io7m/wederian/Datasheets/Amphenol/USB Type-C Receptacle 12401610E4/USB Type-C Receptacle 12401610E4 - Amphenol.jpg

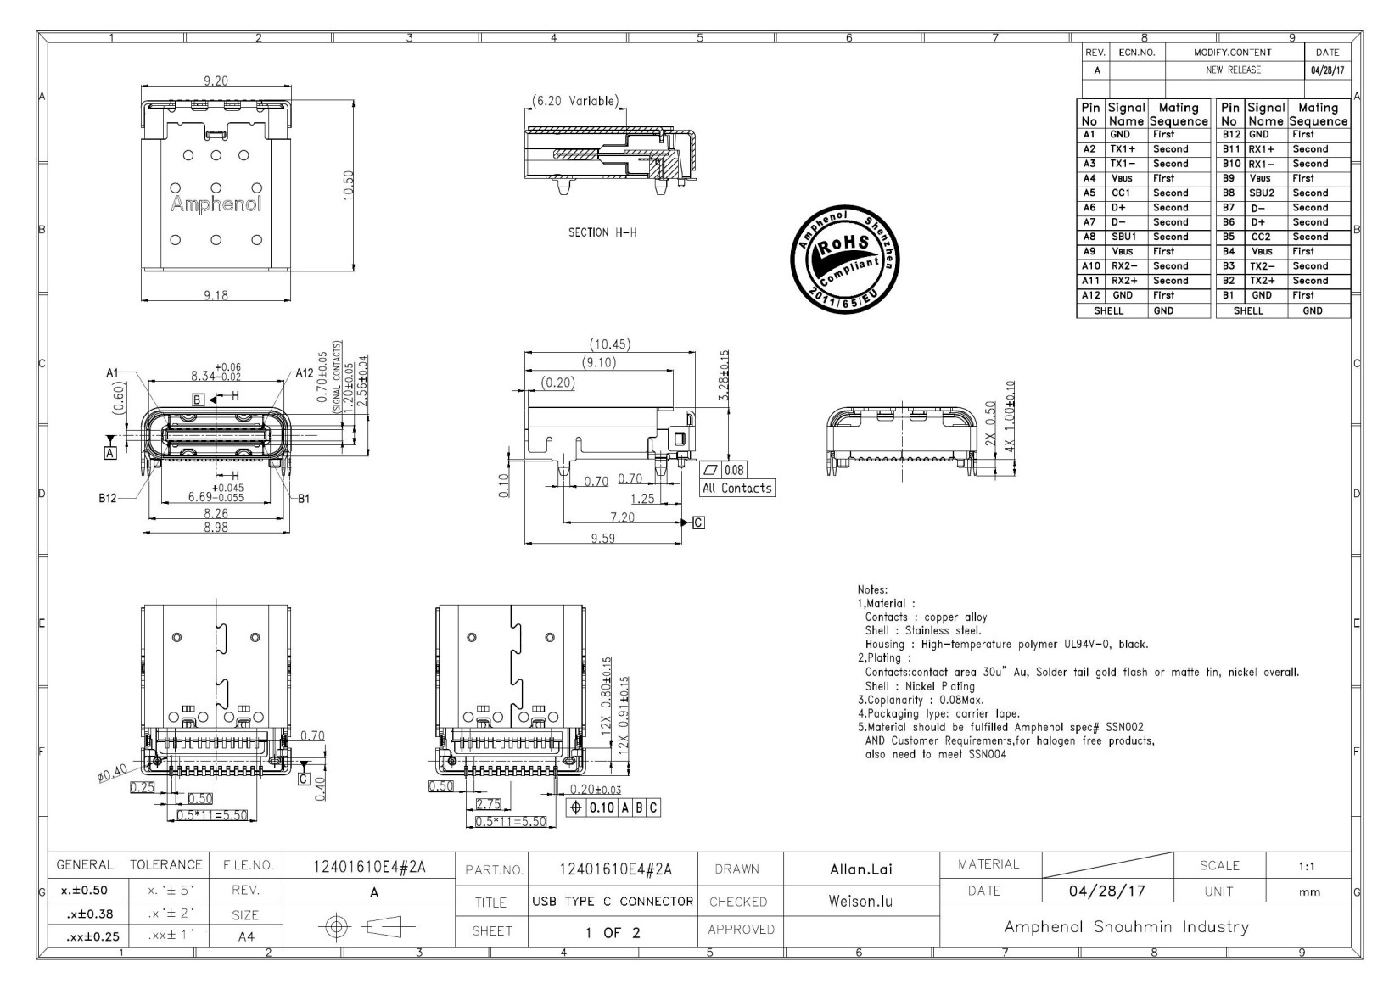
Datasheets/Amphenol/USB Type-C Receptacle 12401610E4/USB Type-C Receptacle 12401610E4 - Amphenol.jpg
