io7m/wederian/Datasheets/Atmel Corporation/ATmega16U4_32U4 Datasheet/ATmega16U4_32U4 Datasheet - Atmel Corporation.jpg

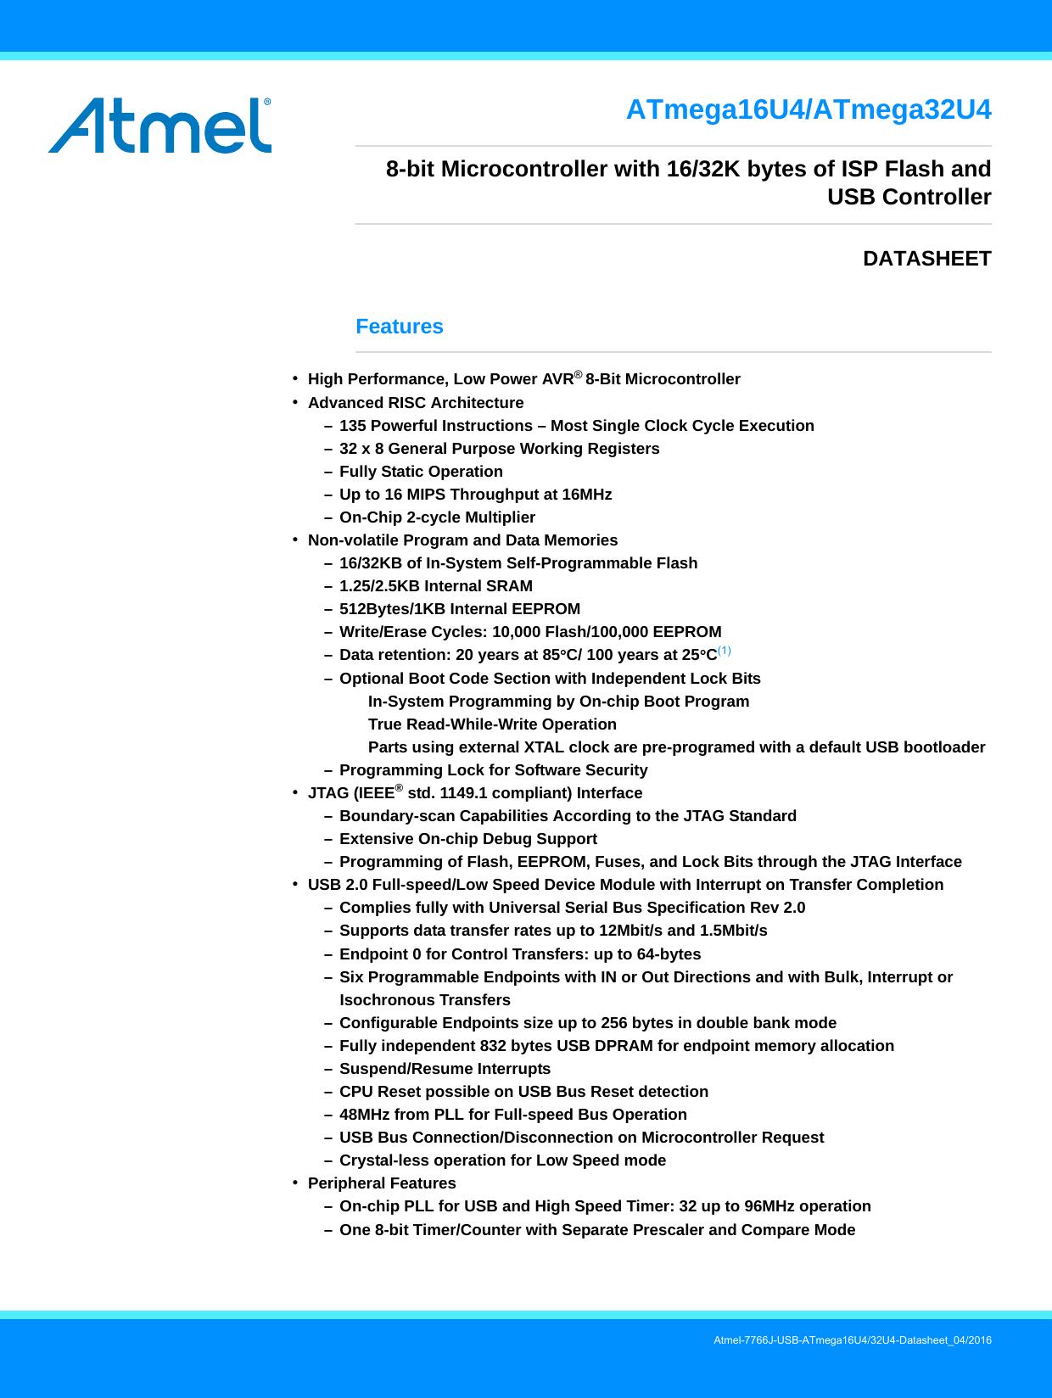
Datasheets/Atmel Corporation/ATmega16U4_32U4 Datasheet/ATmega16U4_32U4 Datasheet - Atmel Corporation.jpg
