io7m/wederian/Datasheets/Bourns, Inc_/ChipGuard® MLC Series ESD Protectors/ChipGuard® MLC Series ESD Protectors - Bourns, Inc_.jpg

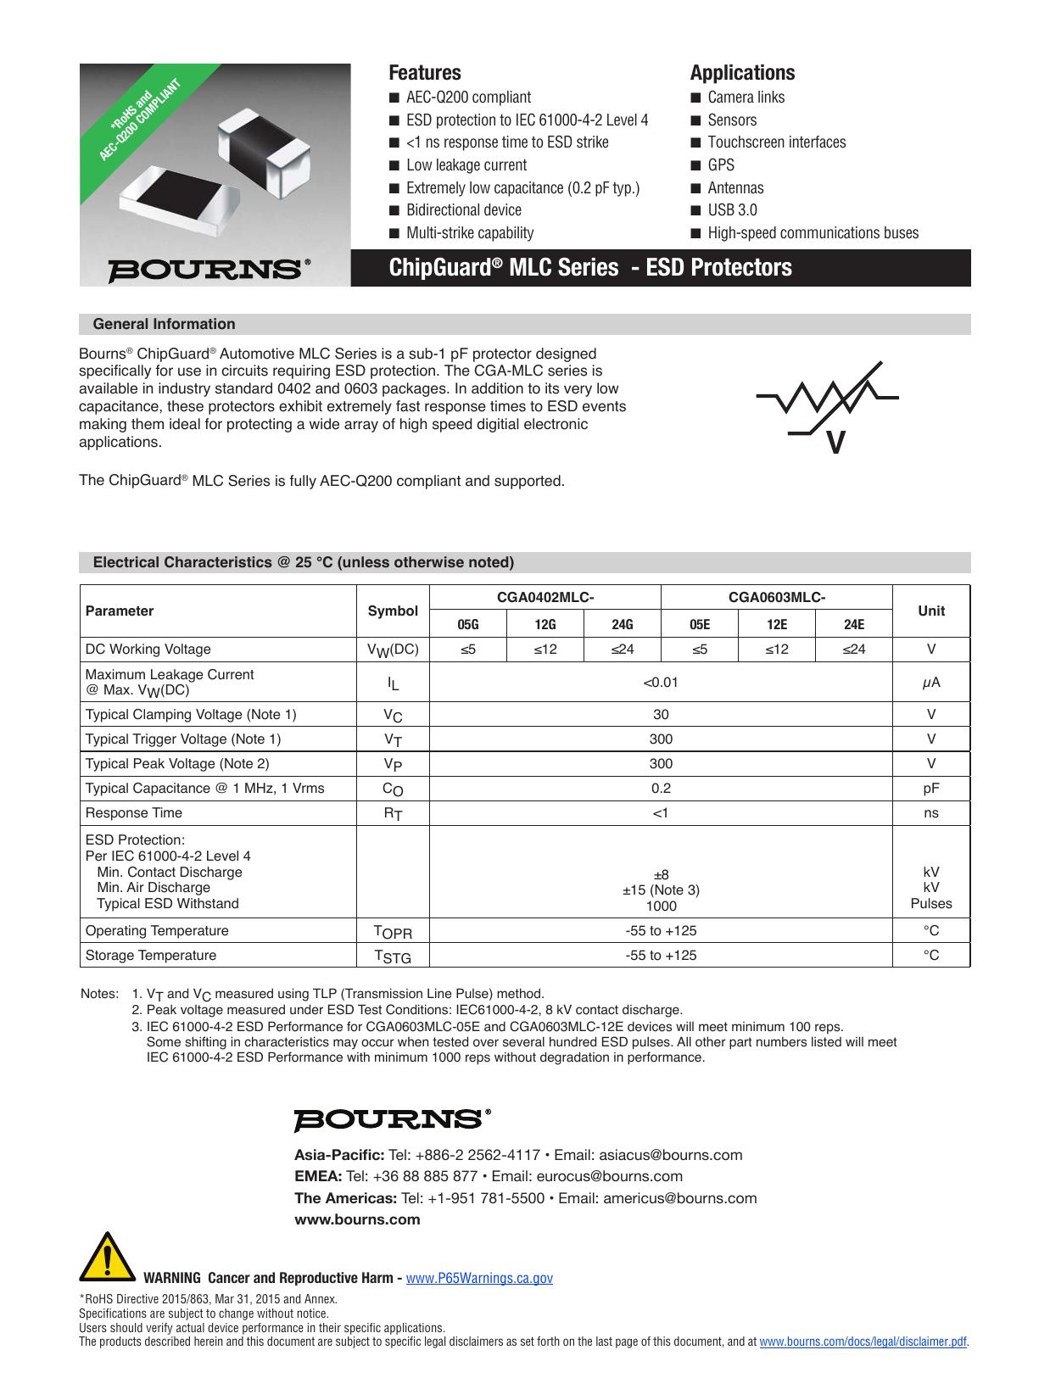
Datasheets/Bourns, Inc_/ChipGuard® MLC Series ESD Protectors/ChipGuard® MLC Series ESD Protectors - Bourns, Inc_.jpg
