io7m/wederian/Datasheets/Bourns, Inc_/MF-MSMF Series PTC Resettable Fuses/MF-MSMF Series PTC Resettable Fuses - Bourns, Inc_.jpg

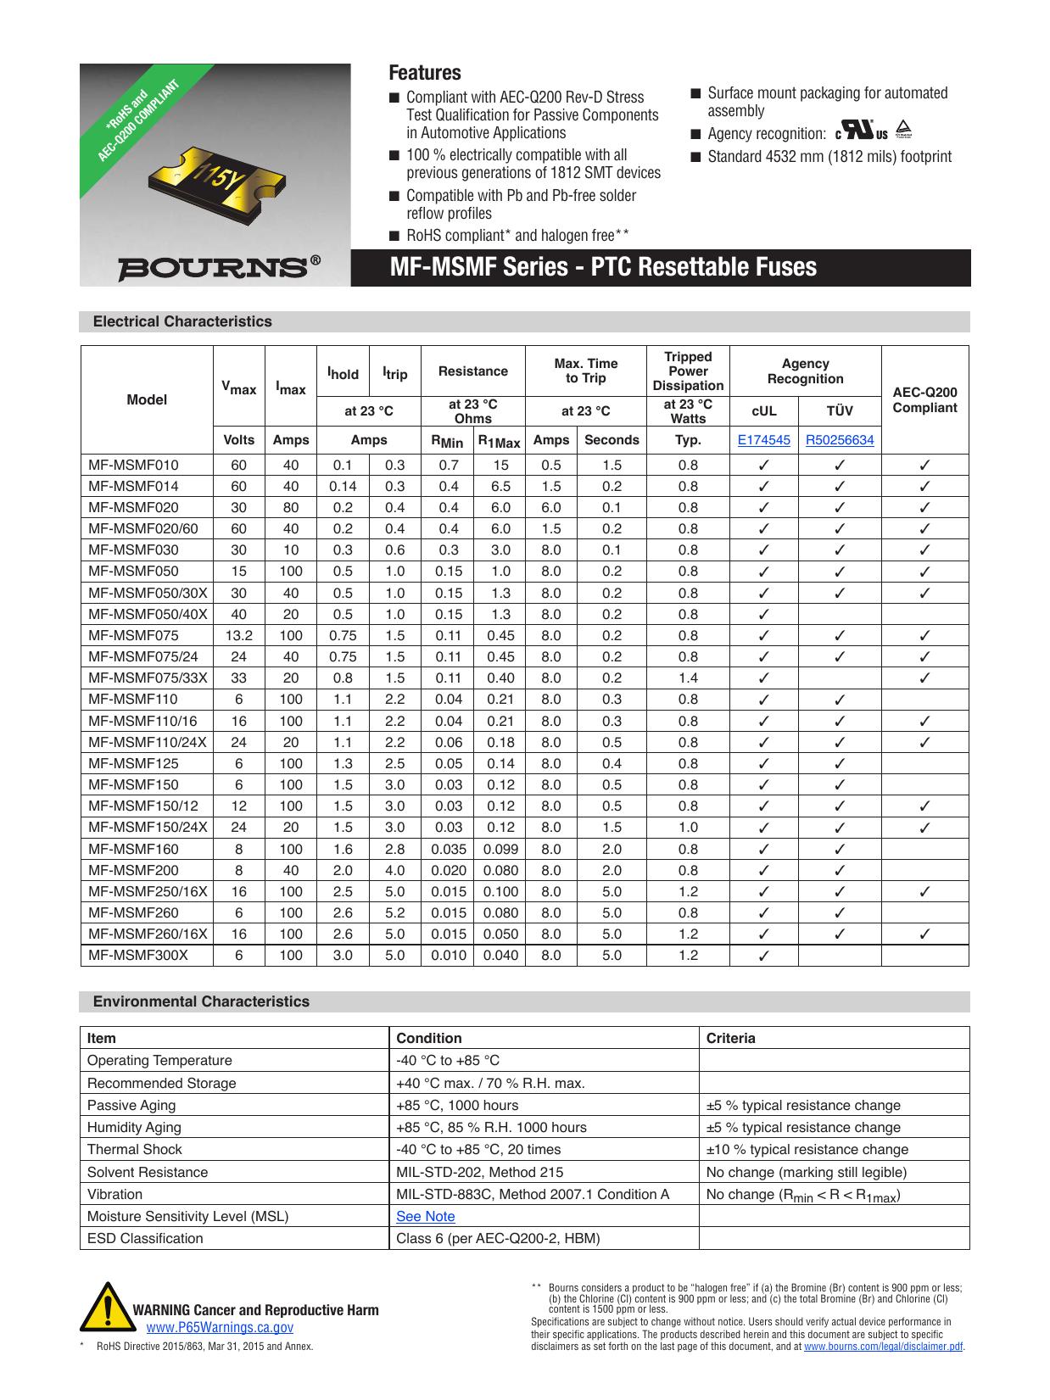
Datasheets/Bourns, Inc_/MF-MSMF Series PTC Resettable Fuses/MF-MSMF Series PTC Resettable Fuses - Bourns, Inc_.jpg
