io7m/wederian/Datasheets/CTS Corporation/ATS_ATS-SM Series/ATS_ATS-SM Series - CTS Corporation.jpg

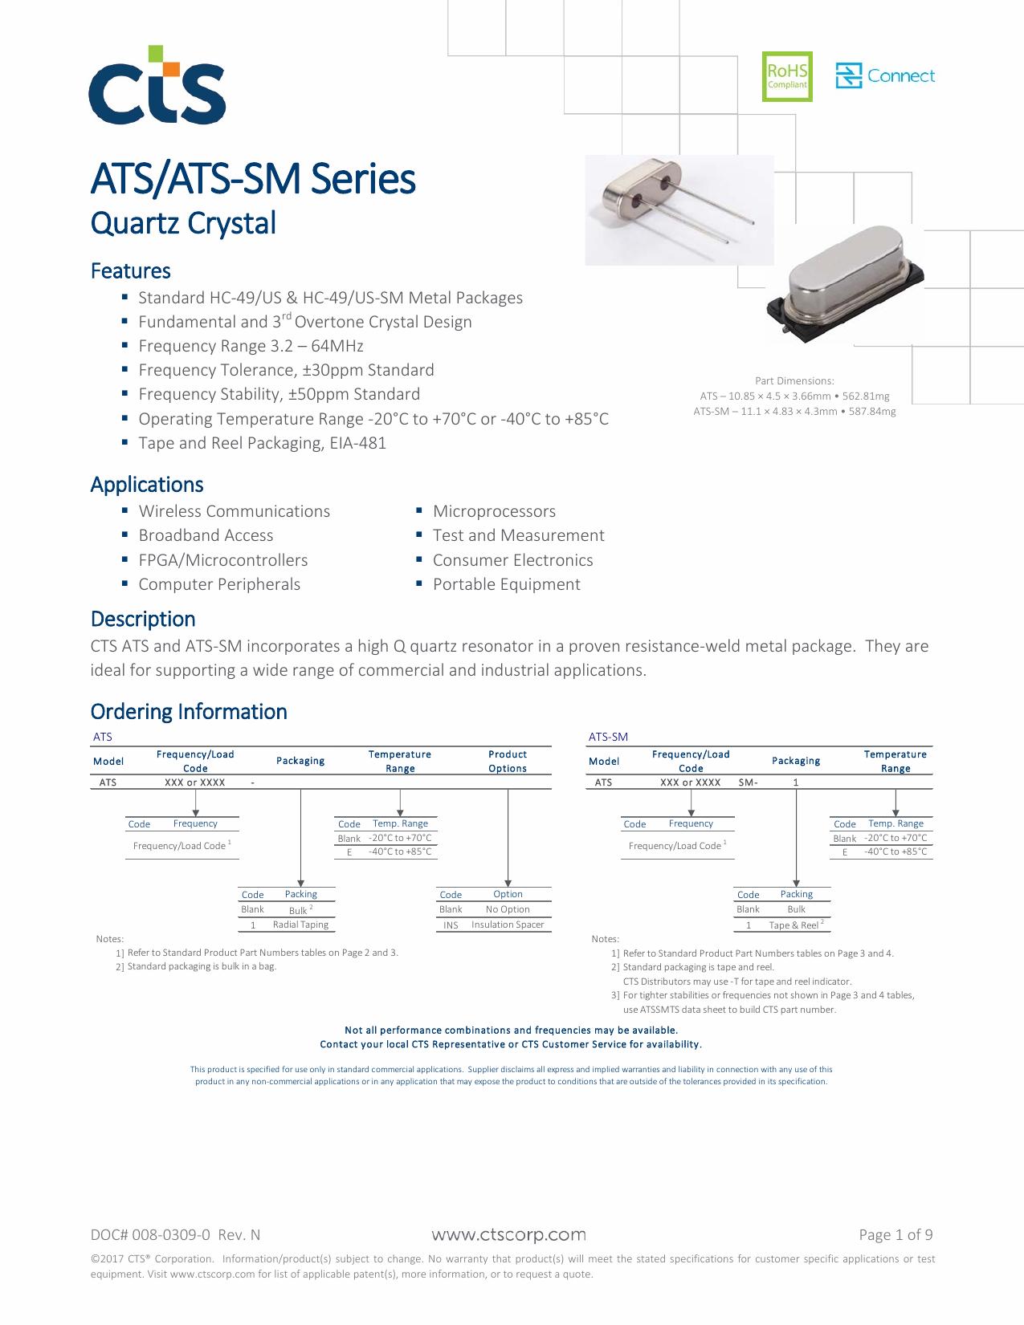
Datasheets/CTS Corporation/ATS_ATS-SM Series/ATS_ATS-SM Series - CTS Corporation.jpg
