io7m/wederian/Datasheets/GCT/BK015/BK015 - GCT.jpg

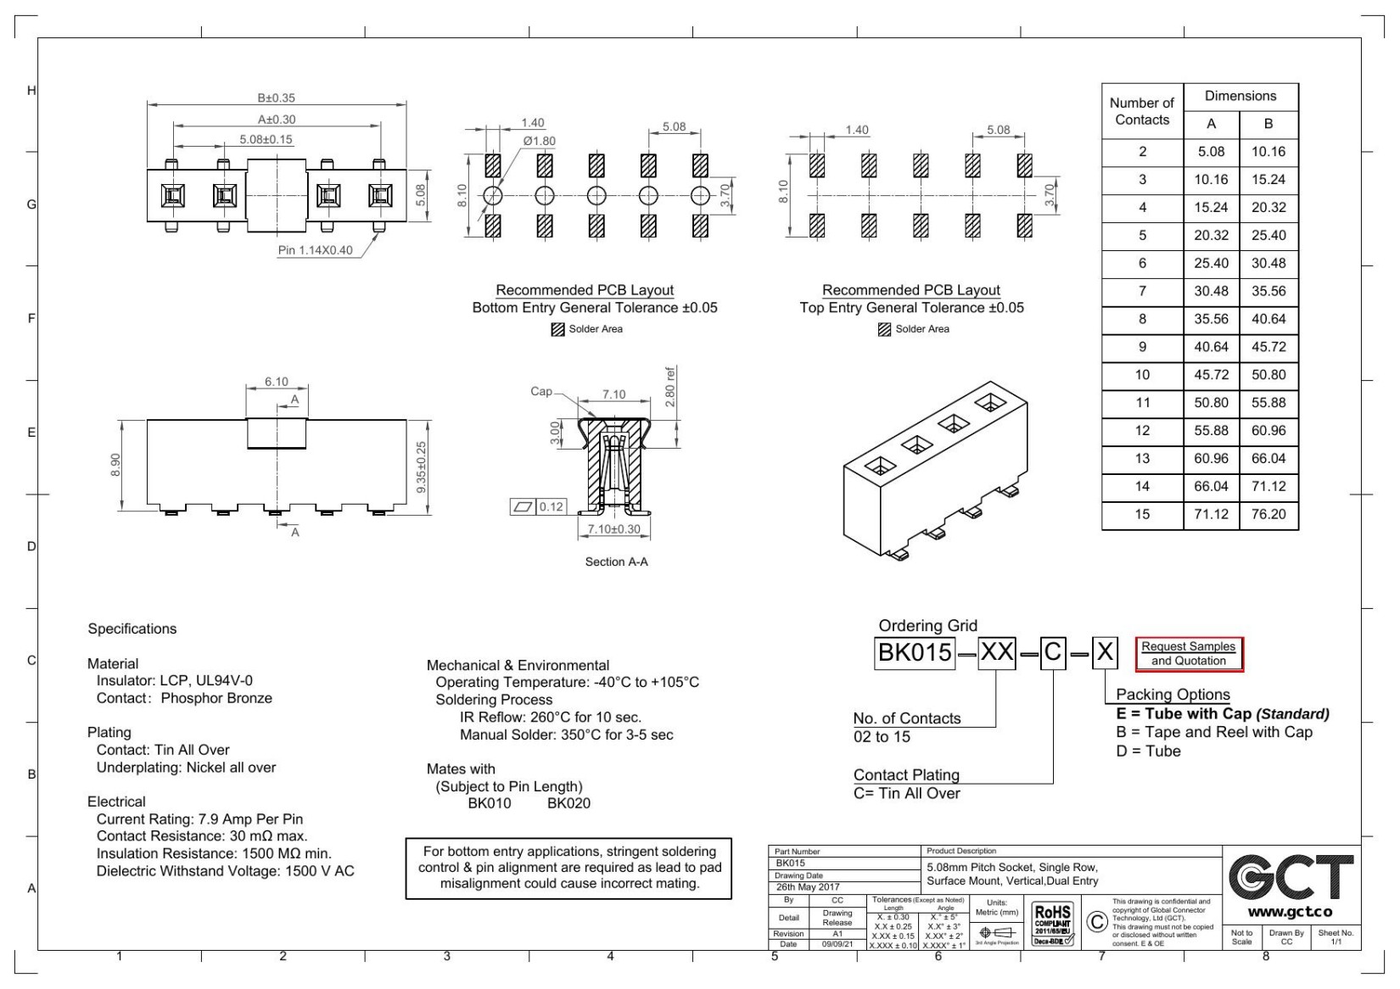
Datasheets/GCT/BK015/BK015 - GCT.jpg
