io7m/wederian/Datasheets/Littelfuse/LPWI Series/LPWI Series - Littelfuse.jpg

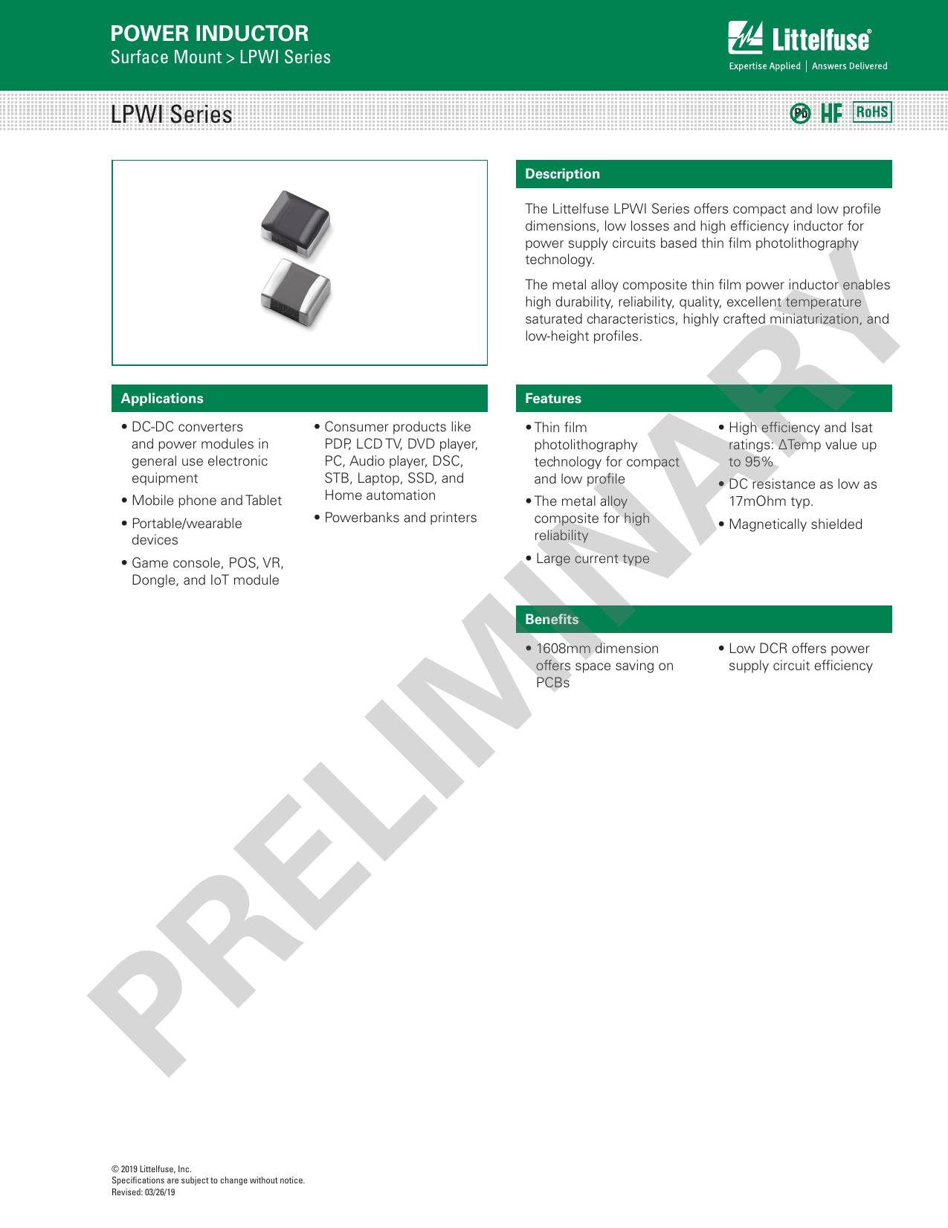
Datasheets/Littelfuse/LPWI Series/LPWI Series - Littelfuse.jpg
