io7m/wederian/Datasheets/Semtech Corporation/SC189/SC189 - Semtech Corporation.jpg

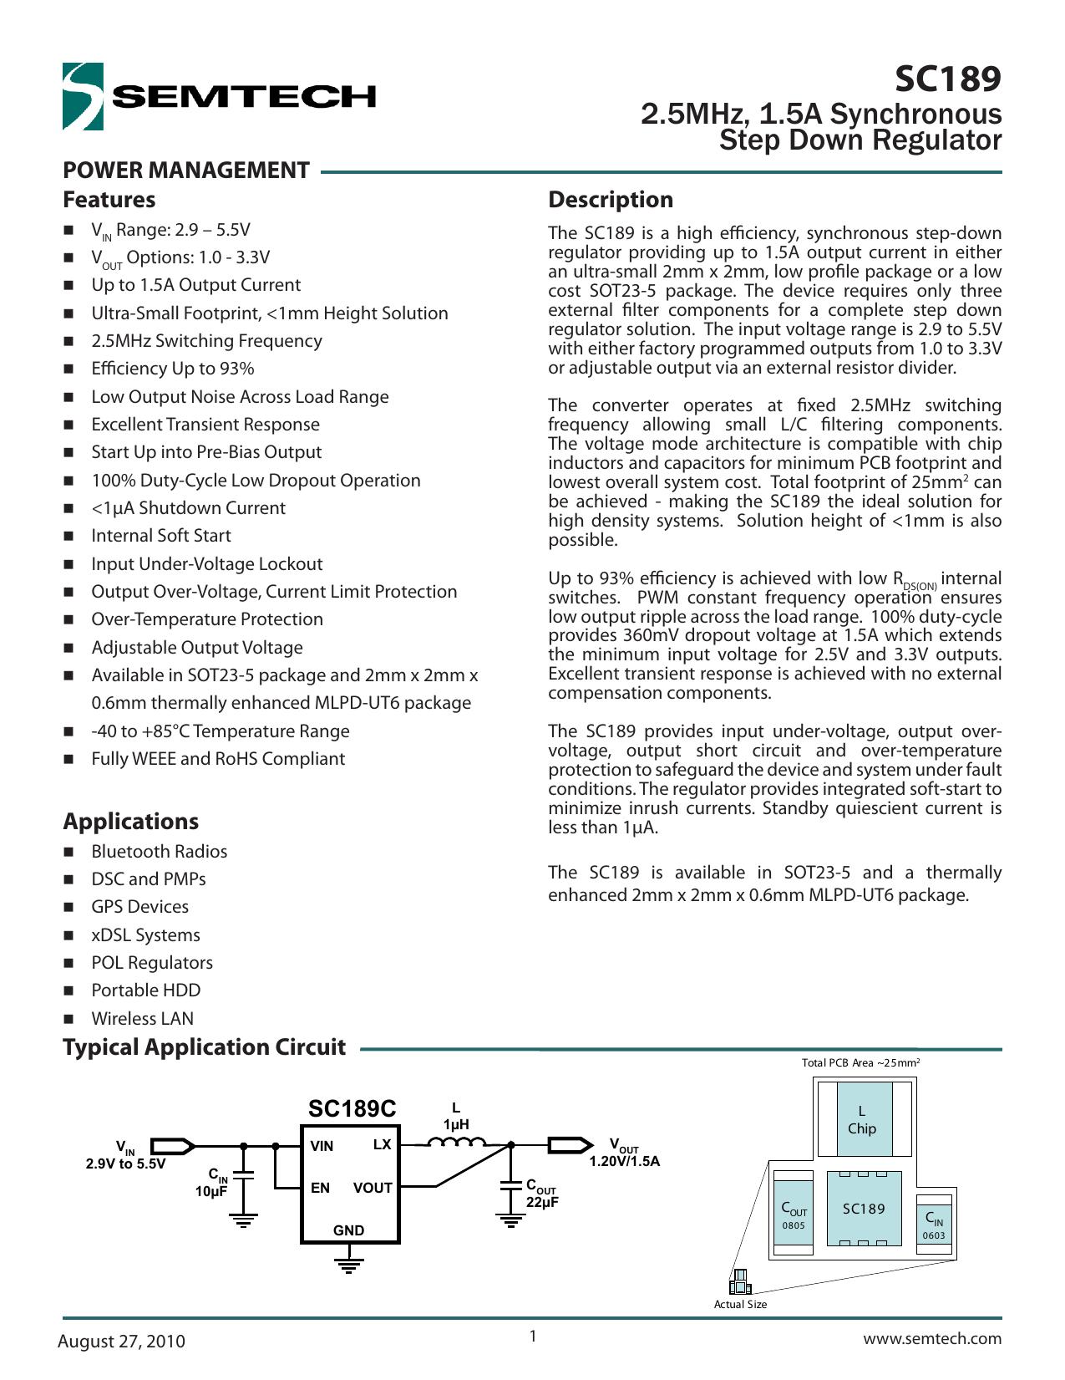
Datasheets/Semtech Corporation/SC189/SC189 - Semtech Corporation.jpg
