io7m/wederian/Datasheets/Sensiron/Sensirion Humidity Sensors SHT3x Datasheet/Sensirion Humidity Sensors SHT3x Datasheet - Sensiron.jpg

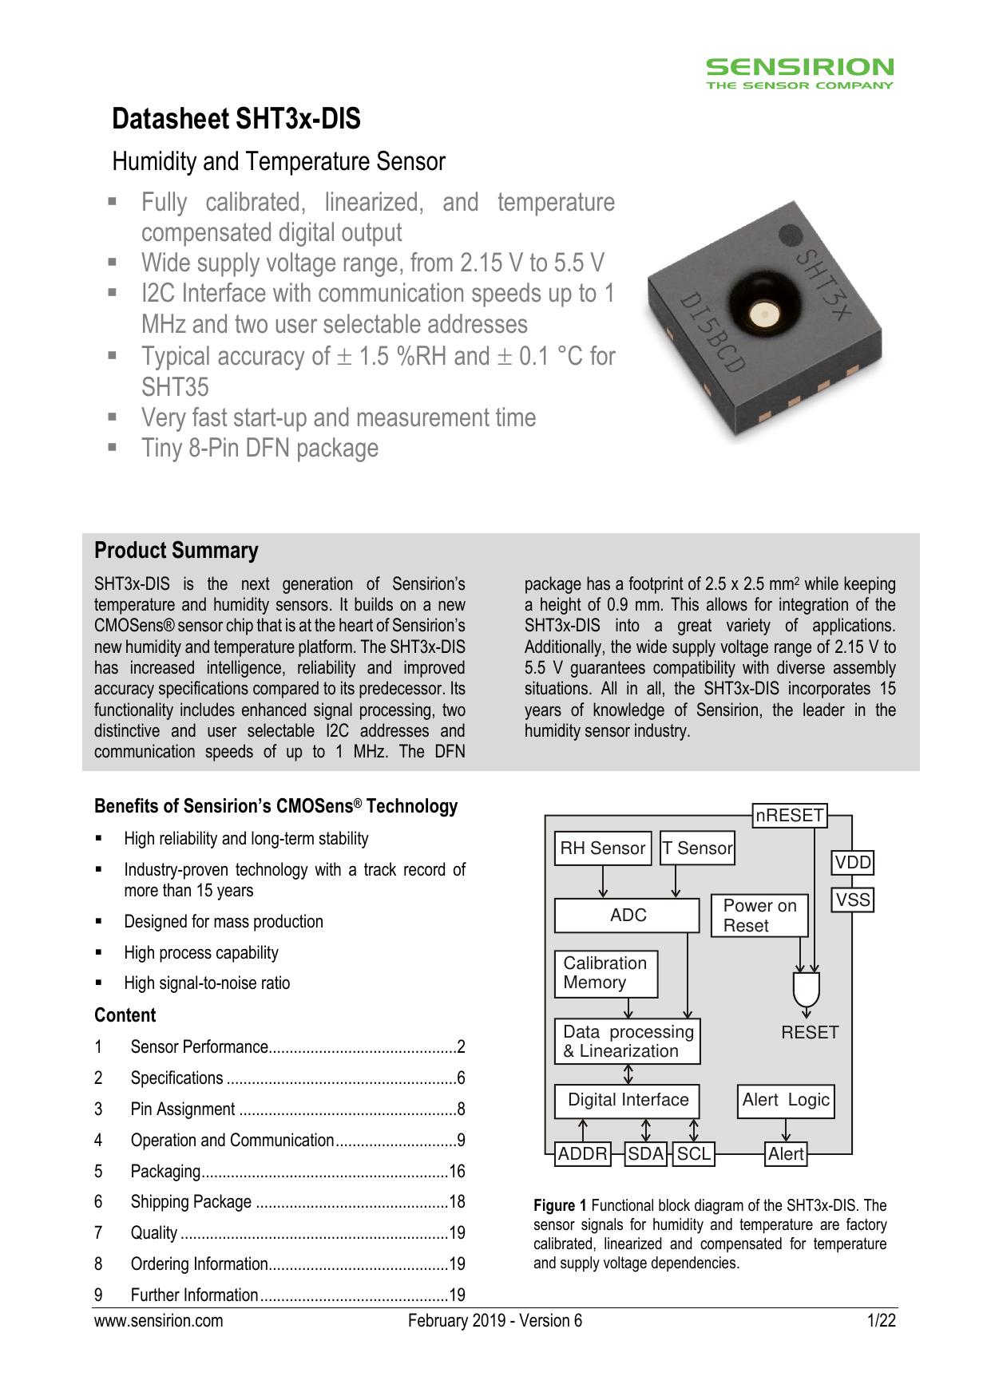
Datasheets/Sensiron/Sensirion Humidity Sensors SHT3x Datasheet/Sensirion Humidity Sensors SHT3x Datasheet - Sensiron.jpg
