io7m/wederian/Datasheets/Assembly, Electronic/Electronic Assembly DOG Series/Electronic Assembly DOG Series - Electronic Assembly.jpg

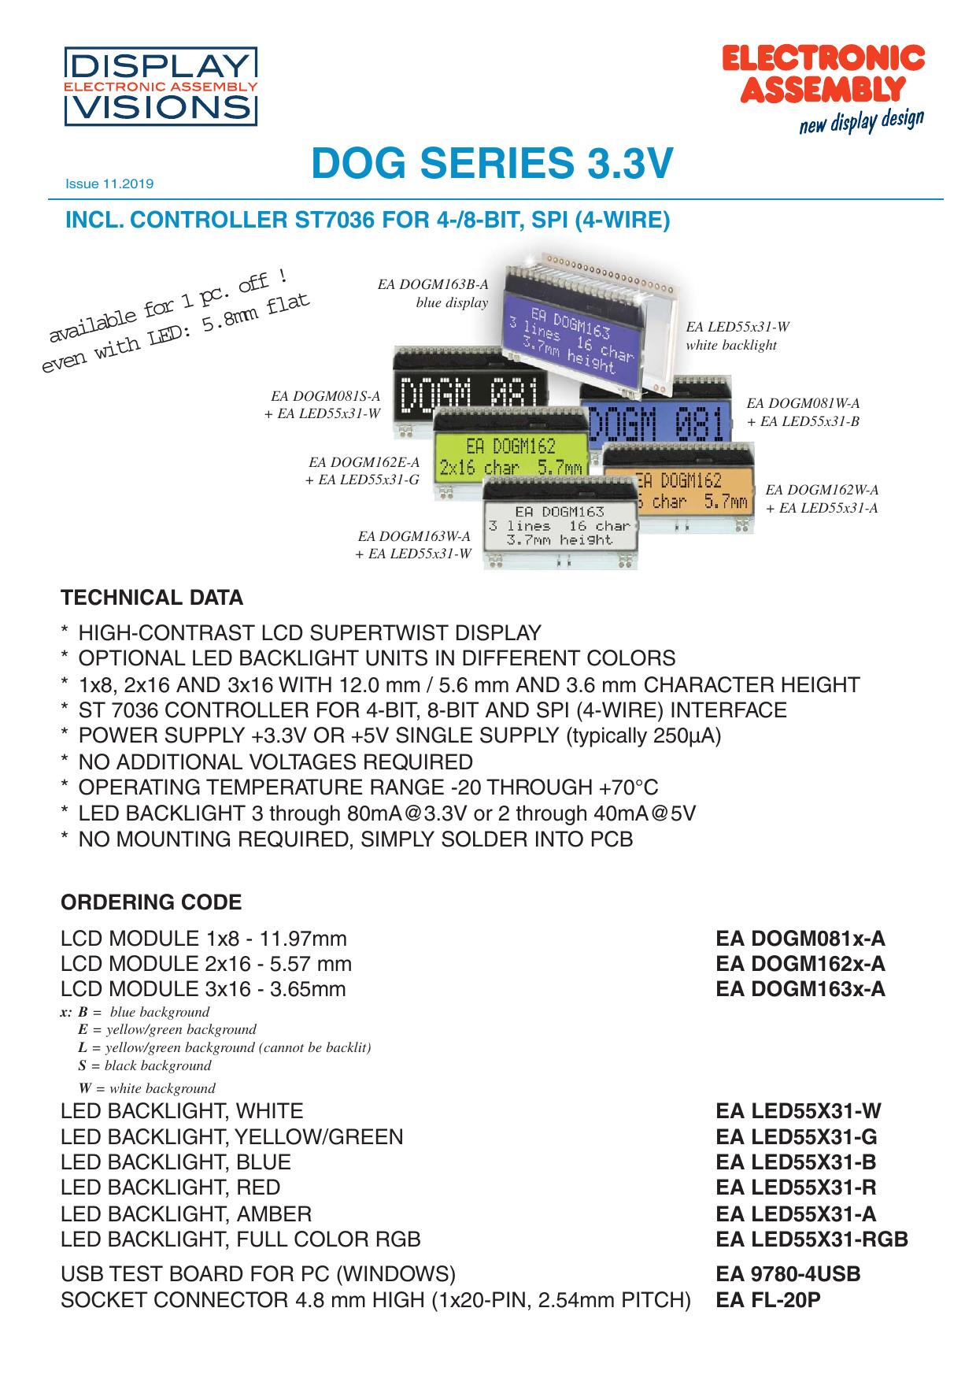
Datasheets/Assembly, Electronic/Electronic Assembly DOG Series/Electronic Assembly DOG Series - Electronic Assembly.jpg
