io7m/wederian/wederian.kicad_pcb

## KiCad design wederian.kicad_pcb (2021-10-24)

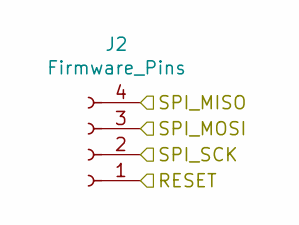
[picture p18: schematic icsp.kicad_sch, Wederian]

Parts:
J2: Firmware_Pins; PinSocket_1x04_P2.00mm_Vertical_SMD_Pin1Left

Connections:
/ICSP/RESET: J2.1; also elsewhere on the board
/ICSP/SPI_MISO: J2.4; also elsewhere on the board
/ICSP/SPI_MOSI: J2.3; also elsewhere on the board
/ICSP/SPI_SCK: J2.2; also elsewhere on the board

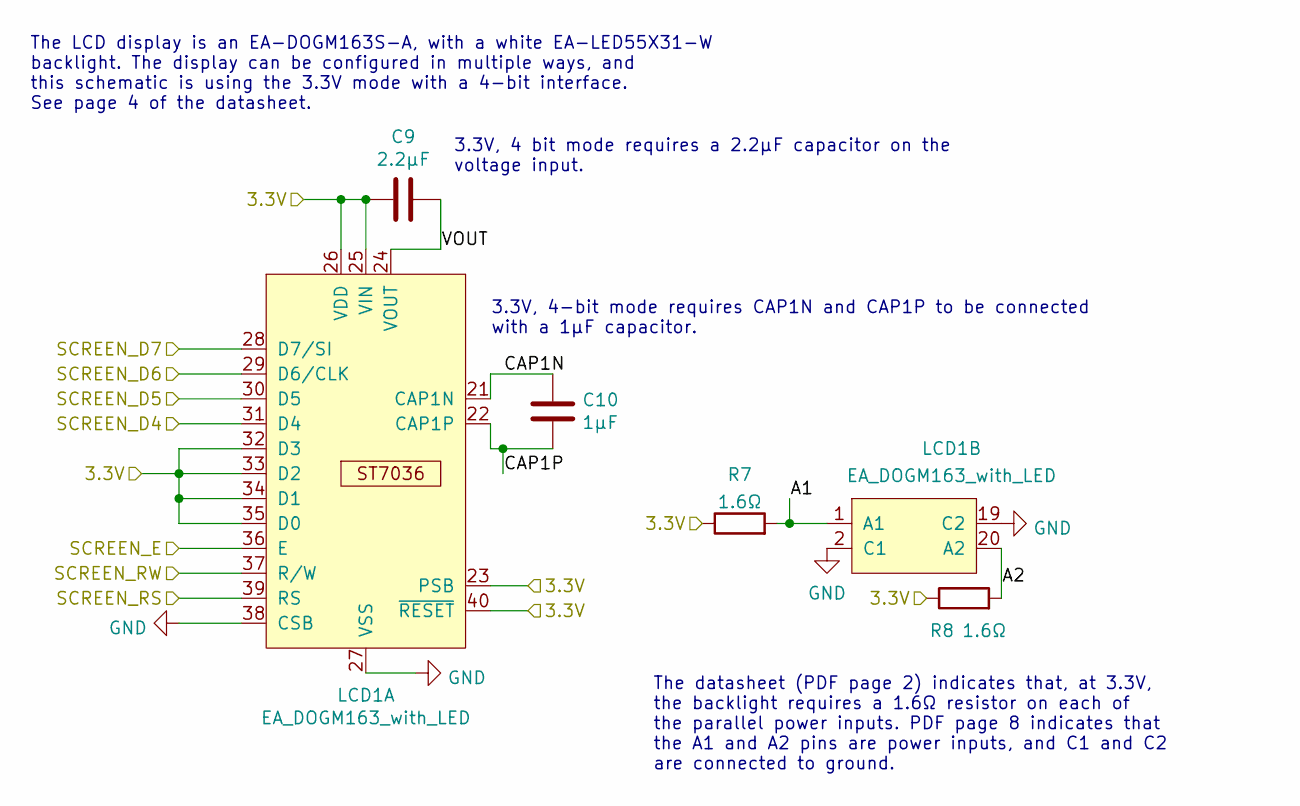
[picture p19: schematic lcd.kicad_sch, Wederian]

Parts:
C9: 2.2μF; C_0603_1608Metric
C10: 1μF; C_0603_1608Metric
LCD1: EA_DOGM163_with_LED; DOGM163_with_LED
R7, R8: 1.6Ω; R_0603_1608Metric

Connections:
/LCD/A1: LCD1.1 (A1), R7.2
/LCD/A2: LCD1.20 (A2), R8.2
/LCD/CAP1N: C10.1, LCD1.21 (CAP1N)
/LCD/CAP1P: C10.2, LCD1.22 (CAP1P)
/LCD/SCREEN_D4: LCD1.31 (D4); also elsewhere on the board
/LCD/SCREEN_D5: LCD1.30 (D5); also elsewhere on the board
/LCD/SCREEN_D6: LCD1.29 (D6/CLK); also elsewhere on the board
/LCD/SCREEN_D7: LCD1.28 (D7/SI); also elsewhere on the board
/LCD/SCREEN_E: LCD1.36 (E); also elsewhere on the board
/LCD/SCREEN_RS: LCD1.39 (RS); also elsewhere on the board
/LCD/SCREEN_RW: LCD1.37 (R/W); also elsewhere on the board
/LCD/VOUT: C9.2, LCD1.24 (VOUT)
/Power Regulation/VOUT: C9.1, LCD1.23 (PSB), LCD1.25 (VIN), LCD1.26 (VDD), LCD1.32 (D3), LCD1.33 (D2), LCD1.34 (D1), LCD1.35 (D0), LCD1.40 (~RESET), R7.1, R8.1; also elsewhere on the board
GND: LCD1.2 (C1), LCD1.19 (C2), LCD1.27 (VSS), LCD1.38 (CSB); also elsewhere on the board

Notes on the sheet:
The LCD display is an EA-DOGM163S-A, with a white EA-LED55X31-W backlight. The display can be configured in multiple ways, and this schematic is using the 3.3V mode with a 4-bit interface. See page 4 of the datasheet.
3.3V, 4 bit mode requires a 2.2μF capacitor on the voltage input.
3.3V, 4-bit mode requires CAP1N and CAP1P to be connected with a 1μF capacitor.
The datasheet (PDF page 2) indicates that, at 3.3V, the backlight requires a 1.6Ω resistor on each of the parallel power inputs. PDF page 8 indicates that the A1 and A2 pins are power inputs, and C1 and C2 are connected to ground.

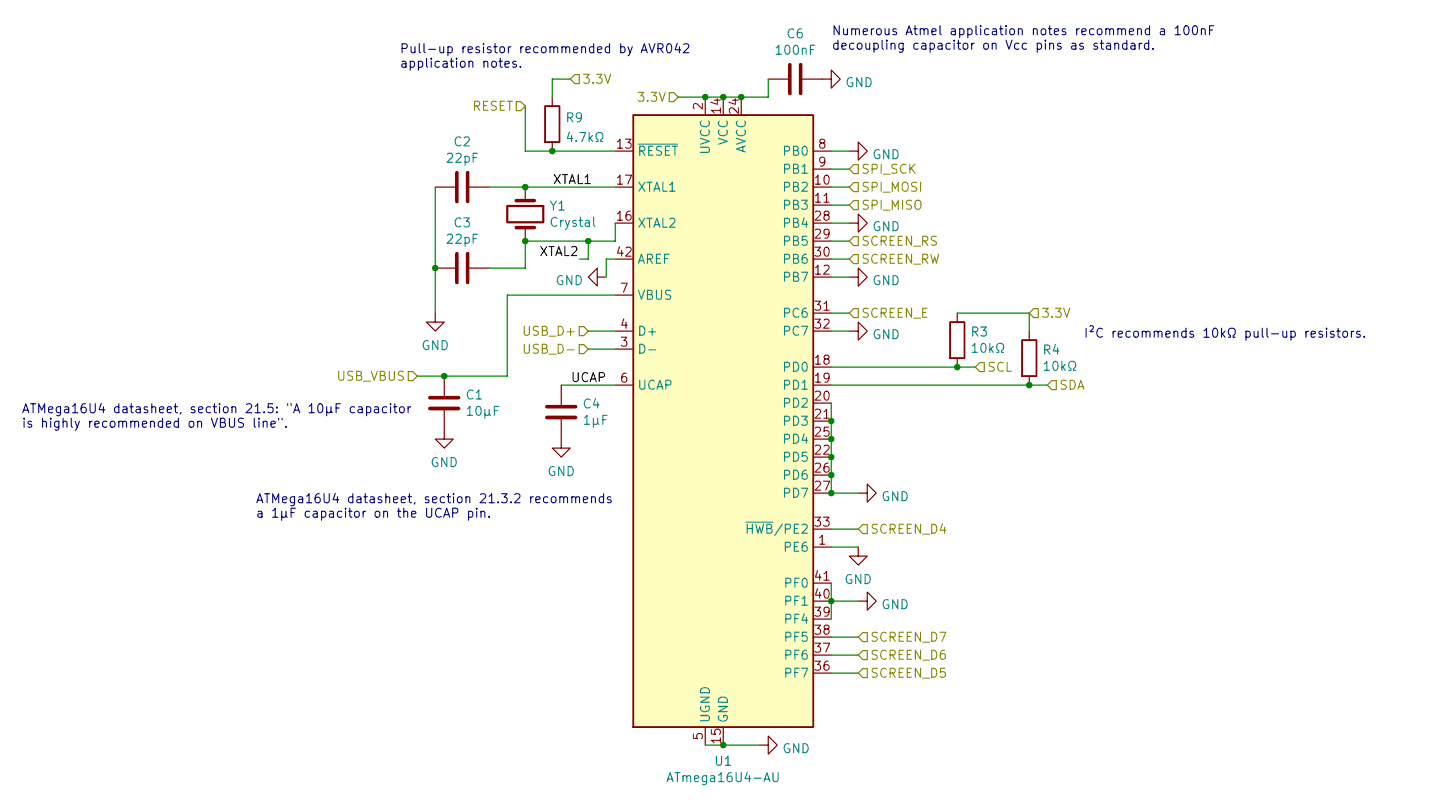
[picture p20: schematic microcontroller.kicad_sch, Wederian]

Parts:
C1: 10μF; C_0805_2012Metric
C2, C3: 22pF; C_0603_1608Metric
C4: 1μF; C_0603_1608Metric
C6: 100nF; C_0603_1608Metric
R3, R4: 10kΩ; R_0603_1608Metric
R9: 4.7kΩ; R_0603_1608Metric
U1: ATmega16U4-AU; TQFP-44_10x10mm_P0.8mm
Y1: Crystal; Crystal_SMD_HC49-SD

Connections:
/ICSP/RESET: R9.2, U1.13 (~RESET); also elsewhere on the board
/ICSP/SPI_MISO: U1.11 (PB3); also elsewhere on the board
/ICSP/SPI_MOSI: U1.10 (PB2); also elsewhere on the board
/ICSP/SPI_SCK: U1.9 (PB1); also elsewhere on the board
/LCD/SCREEN_D4: U1.33 (~HWB/PE2); also elsewhere on the board
/LCD/SCREEN_D5: U1.36 (PF7); also elsewhere on the board
/LCD/SCREEN_D6: U1.37 (PF6); also elsewhere on the board
/LCD/SCREEN_D7: U1.38 (PF5); also elsewhere on the board
/LCD/SCREEN_E: U1.31 (PC6); also elsewhere on the board
/LCD/SCREEN_RS: U1.29 (PB5); also elsewhere on the board
/LCD/SCREEN_RW: U1.30 (PB6); also elsewhere on the board
/Microcontroller/SCL: R3.2, U1.18 (PD0); also elsewhere on the board
/Microcontroller/SDA: R4.2, U1.19 (PD1); also elsewhere on the board
/Microcontroller/UCAP: C4.1, U1.6 (UCAP)
/Microcontroller/USB_D+: U1.4 (D+); also elsewhere on the board
/Microcontroller/USB_D-: U1.3 (D-); also elsewhere on the board
/Microcontroller/USB_VBUS: C1.1, U1.7 (VBUS); also elsewhere on the board
/Microcontroller/XTAL1: C2.1, U1.17 (XTAL1), Y1.1
/Microcontroller/XTAL2: C3.1, U1.16 (XTAL2), Y1.2
/Power Regulation/VOUT: C6.2, R3.1, R4.1, R9.1, U1.2 (UVCC), U1.14 (VCC), U1.24 (AVCC), U1.34 (VCC), U1.44 (AVCC); also elsewhere on the board
GND: C1.2, C2.2, C3.2, C4.2, C6.1, U1.1 (PE6), U1.5 (UGND), U1.8 (PB0), U1.12 (PB7), U1.15 (GND), U1.20 (PD2), U1.21 (PD3), U1.22 (PD5), U1.23 (GND), U1.25 (PD4), U1.26 (PD6), U1.27 (PD7), U1.28 (PB4), U1.32 (PC7), U1.35 (GND), U1.39 (PF4), U1.40 (PF1), U1.41 (PF0), U1.42 (AREF), U1.43 (GND); also elsewhere on the board

Notes on the sheet:
ATMega16U4 datasheet, section 21.5: "A 10μF capacitor is highly recommended on VBUS line".
ATMega16U4 datasheet, section 21.3.2 recommends a 1μF capacitor on the UCAP pin.
Pull-up resistor recommended by AVR042 application notes.
Numerous Atmel application notes recommend a 100nF decoupling capacitor on Vcc pins as standard.
I²C recommends 10kΩ pull-up resistors.

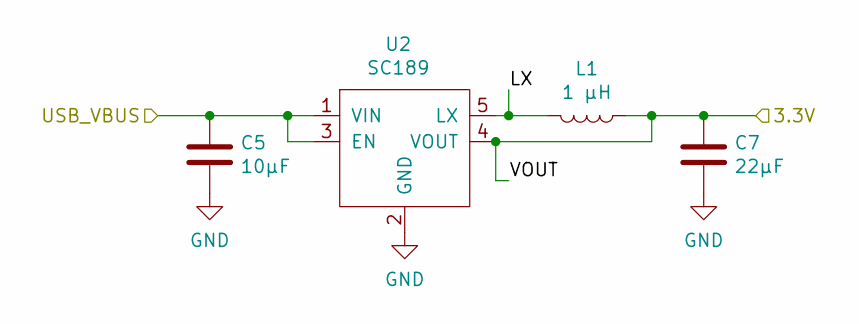
[picture p21: schematic powerRegulation.kicad_sch, Wederian]

Parts:
C5: 10μF; C_0805_2012Metric
C7: 22μF; C_0805_2012Metric
L1: 1 μH; L_0805_2012Metric
U2: SC189; SOT-23-5

Connections:
/Microcontroller/USB_VBUS: C5.1, U2.1 (VIN), U2.3 (EN); also elsewhere on the board
/Power Regulation/LX: L1.2, U2.5 (LX)
/Power Regulation/VOUT: C7.1, L1.1, U2.4 (VOUT); also elsewhere on the board
GND: C5.2, C7.2, U2.2 (GND); also elsewhere on the board

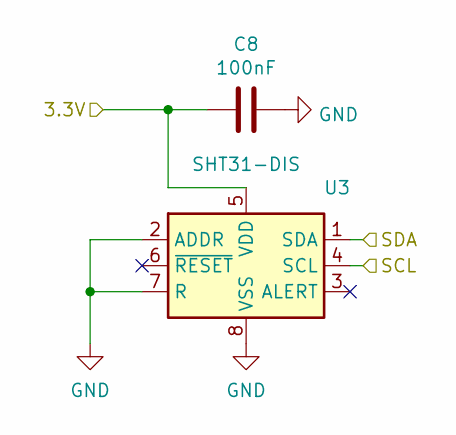
[picture p22: schematic sensor.kicad_sch, Wederian]

Parts:
C8: 100nF; C_0603_1608Metric
U3: SHT31-DIS; Sensirion_DFN-8-1EP_2.5x2.5mm_P0.5mm_EP1.1x1.7mm

Connections:
/Microcontroller/SCL: U3.4 (SCL); also elsewhere on the board
/Microcontroller/SDA: U3.1 (SDA); also elsewhere on the board
/Power Regulation/VOUT: C8.1, U3.5 (VDD); also elsewhere on the board
GND: C8.2, U3.2 (ADDR), U3.7 (R), U3.8 (VSS), U3.9 (VSS); also elsewhere on the board

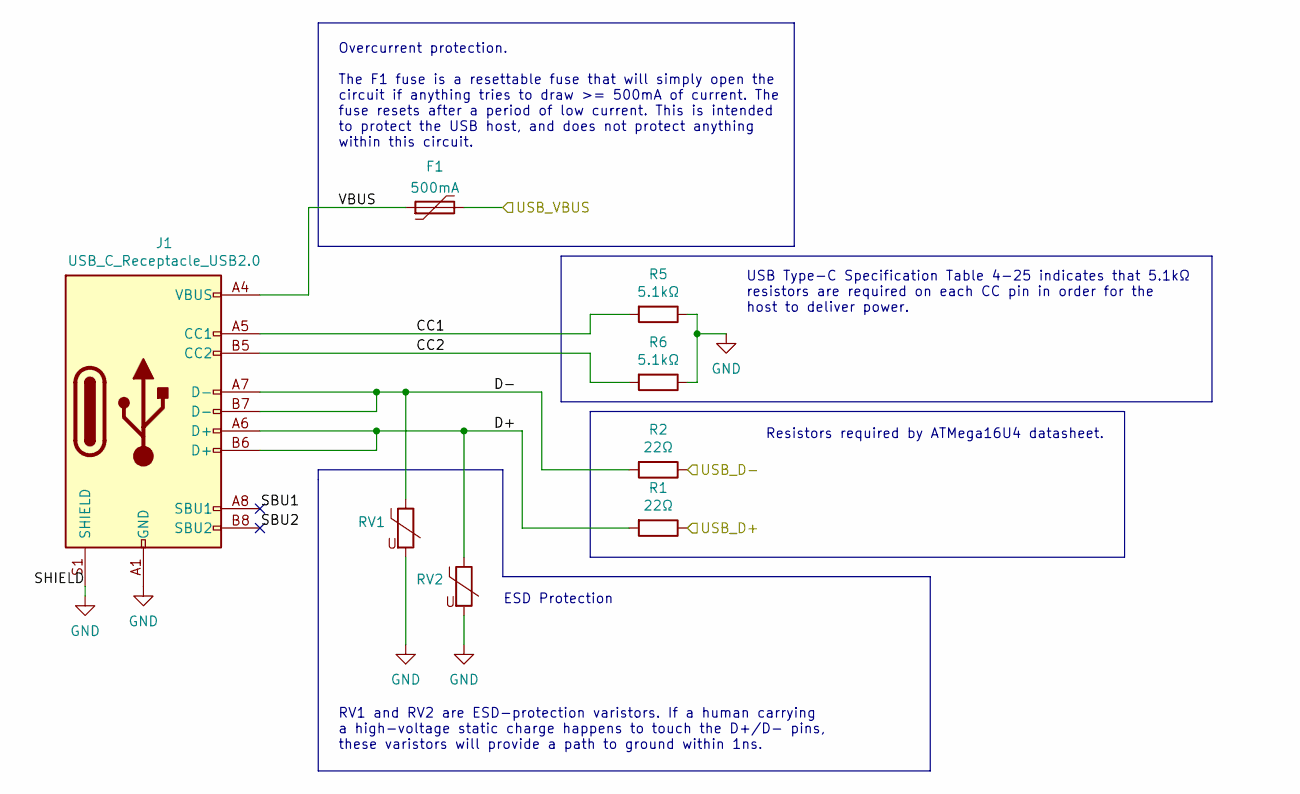
[picture p23: schematic usb.kicad_sch, Wederian]

Parts:
F1: 500mA; Fuse_1812_4532Metric
J1: USB_C_Receptacle_USB2.0; USB_C_Receptacle_Amphenol_12401610E4-2A
R1, R2: 22Ω; R_0603_1608Metric
R5, R6: 5.1kΩ; R_0603_1608Metric
RV1, RV2: CG0603MLC-05E; R_0603_1608Metric

Connections:
/Microcontroller/USB_D+: R1.1; also elsewhere on the board
/Microcontroller/USB_D-: R2.1; also elsewhere on the board
/Microcontroller/USB_VBUS: F1.2; also elsewhere on the board
/USB/CC1: J1.A5 (CC1), R5.2
/USB/CC2: J1.B5 (CC2), R6.2
/USB/D+: J1.A6 (D+), J1.B6 (D+), R1.2, RV2.1
/USB/D-: J1.A7 (D-), J1.B7 (D-), R2.2, RV1.1
/USB/SBU1: J1.A8 (SBU1)
/USB/SBU2: J1.B8 (SBU2)
/USB/VBUS: F1.1, J1.A4 (VBUS), J1.A9 (VBUS), J1.B4 (VBUS), J1.B9 (VBUS)
GND: J1.A1 (GND), J1.A12 (GND), J1.B1 (GND), J1.B12 (GND), J1.S1 (SHIELD), R5.1, R6.1, RV1.2, RV2.2; also elsewhere on the board

Notes on the sheet:
Overcurrent protection. The F1 fuse is a resettable fuse that will simply open the circuit if anything tries to draw >= 500mA of current. The fuse resets after a period of low current. This is intended to protect the USB host, and does not protect anything within this circuit.
RV1 and RV2 are ESD-protection varistors. If a human carrying a high-voltage static charge happens to touch the D+/D- pins, these varistors will provide a path to ground within 1ns.
ESD Protection
USB Type-C Specification Table 4-25 indicates that 5.1kΩ resistors are required on each CC pin in order for the host to deliver power.
Resistors required by ATMega16U4 datasheet.

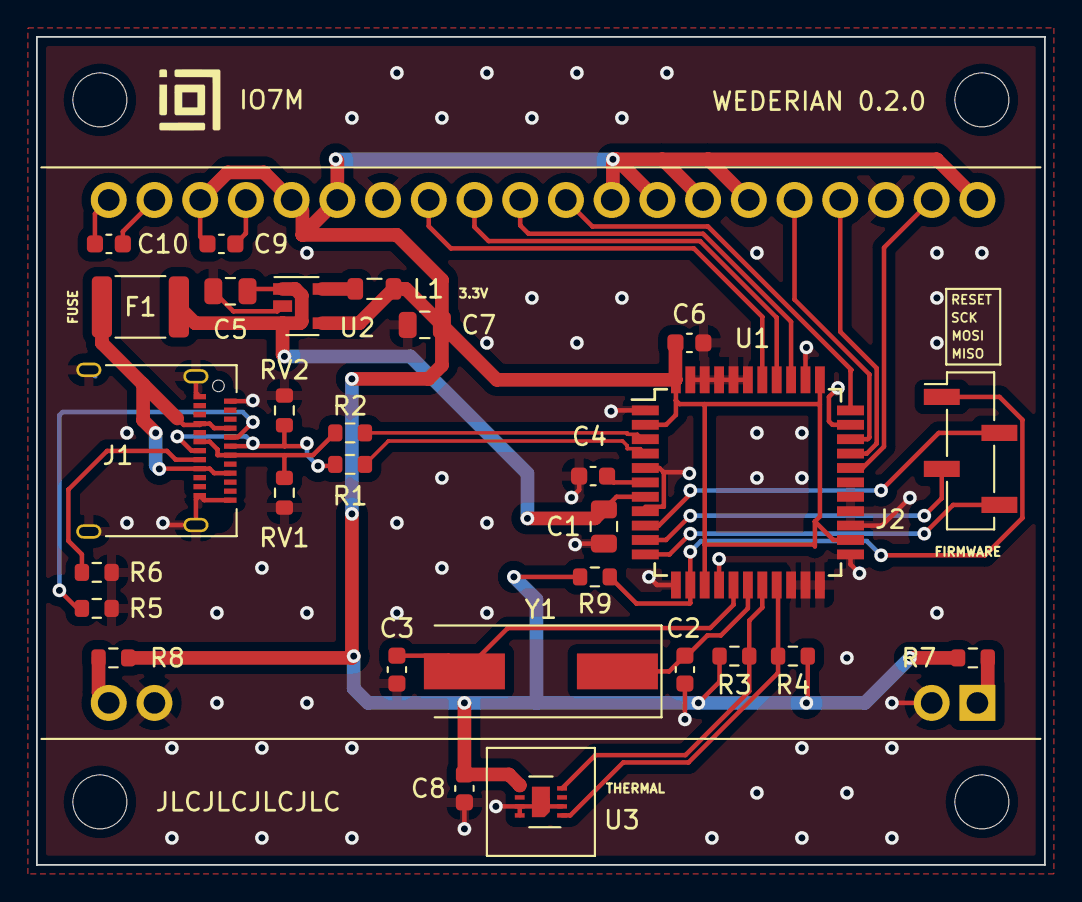
[picture p24: board wederian.kicad_pcb from above]

Board: 2 copper layers, 56.0 x 46.0 mm, 30 parts (1 on the bottom side), 32 nets.
