io7m/wederian/(commit log)

2021-10-24 Initial version
    [icsp.kicad_sch, lcd.kicad_sch, microcontroller.kicad_sch, powerRegulation.kicad_sch, sensor.kicad_sch, usb.kicad_sch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]
2021-10-24 Correctly set sheet pin directions
    [wederian.kicad_sch]
